gonzalesomar/Agrosense_IoT/agrosense/Impact/Readme.txt

Thanks for downloading this template!

Template Name: Impact
Template URL: https://bootstrapmade.com/impact-bootstrap-business-website-template/
Author: BootstrapMade.com
License: https://bootstrapmade.com/license/
