gonzalesomar/Agrosense_IoT/Estacion_Control/CajaTapa.stl

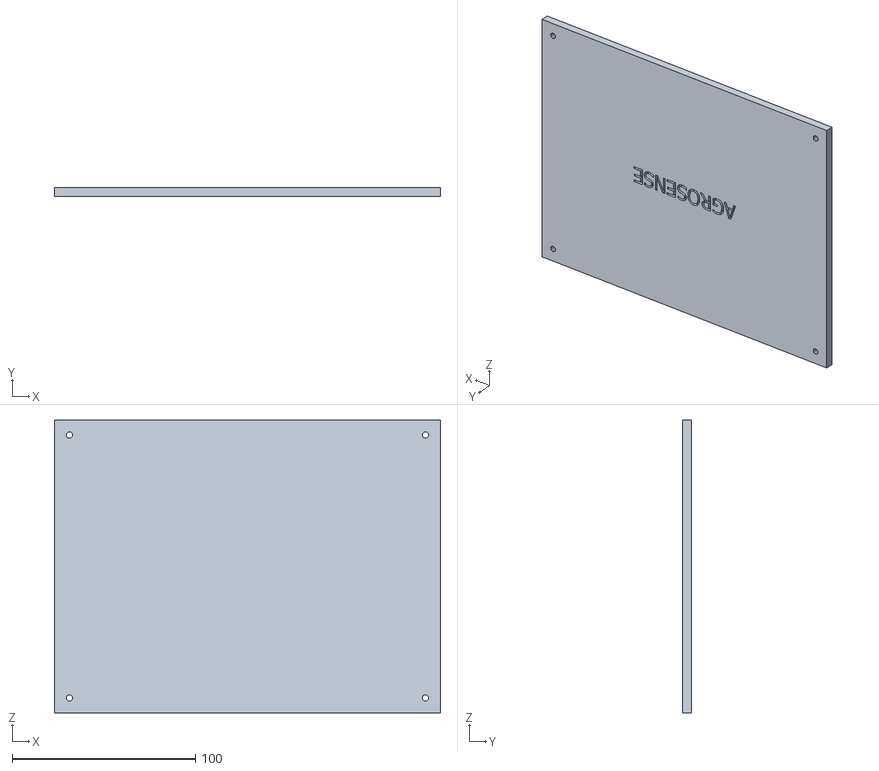
[picture p9: CAD file, 2024-07-15]
Estacion_Control/CajaTapa.stl
210.9 x 5.00 x 160.0
