gonzalesomar/Agrosense_IoT/(list of files, cad)

Other CAD files:
Estacion_Control/CajaPart1_FinalDefinitivoCopyCrepe.ipt
Estacion_Control/CajaPart2_FinalDef.ipt
Sistema_Sensado/Box.ipt
Sistema_Sensado/Lid.ipt
