gonzalesomar/Agrosense_IoT/agrosense/dashboard/admin.py

from django.contrib import admin
from .models import Feature
from .models import SensorData_1, SensorData_2

    
    
    
# Register your models here.
admin.site.register(Feature)
admin.site.register(SensorData_1)
admin.site.register(SensorData_2)
